ivandivito/gepetto/circuitos/circuito control/circuito_control_esquematico.jpg

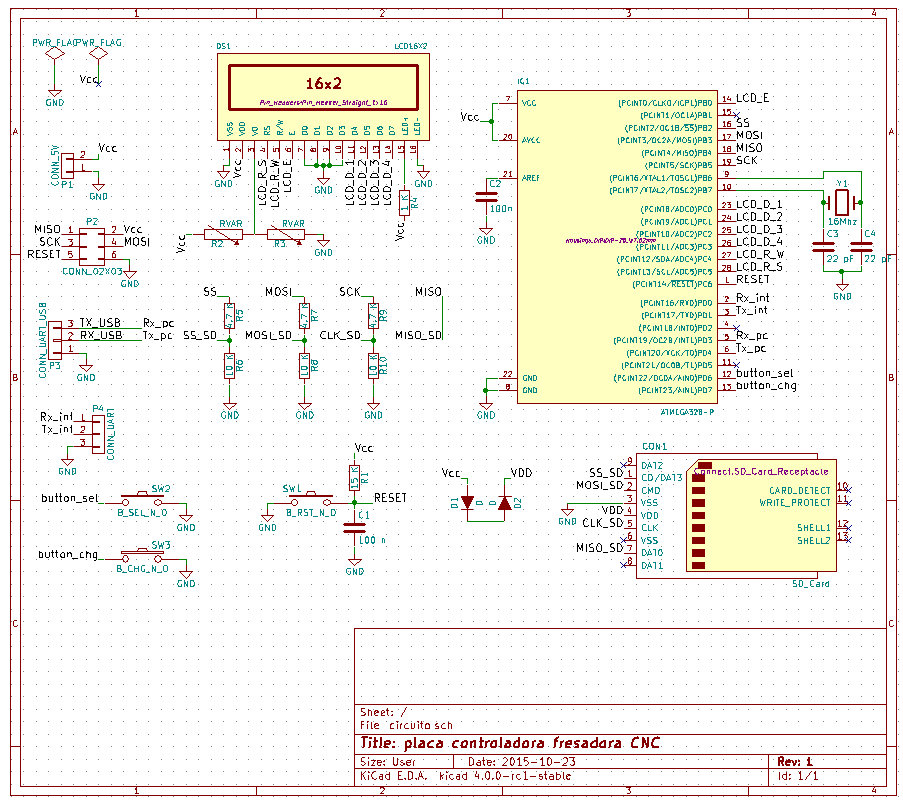
circuitos/circuito control/circuito_control_esquematico.jpg
