ivandivito/gepetto/circuitos/circuito control/circuito_control_pcv.jpg

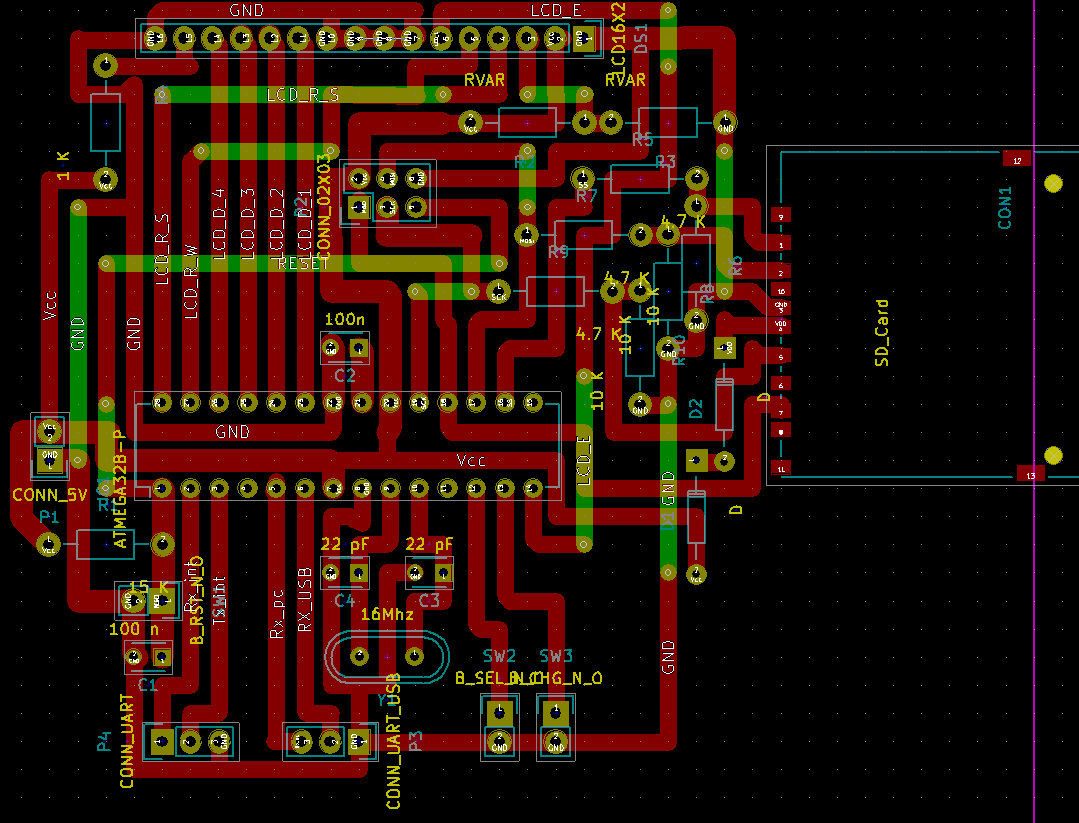
circuitos/circuito control/circuito_control_pcv.jpg
