ivandivito/gepetto/circuitos/circuito interprete/esquematico interprete.jpg

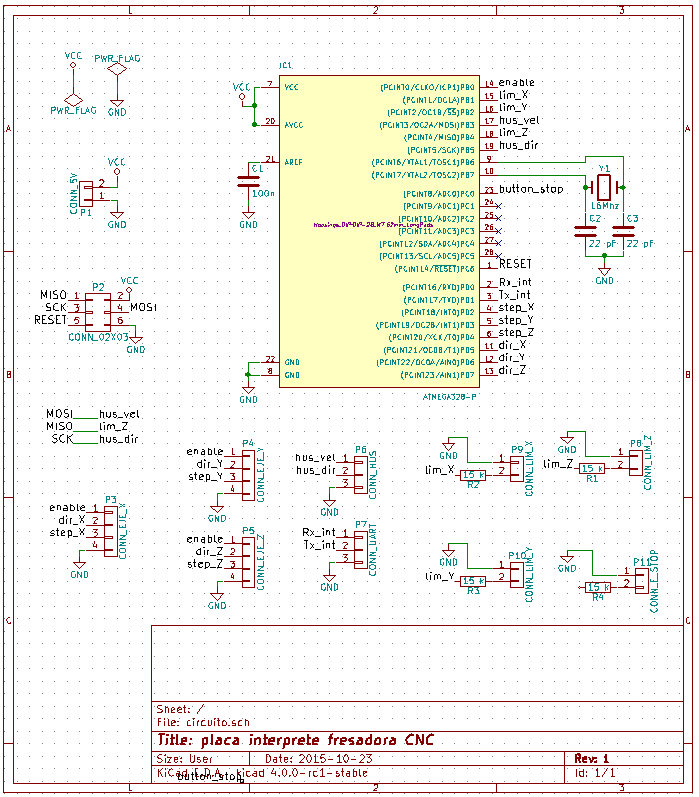
circuitos/circuito interprete/esquematico interprete.jpg
