ivandivito/gepetto/circuitos/circuito interprete/pcv interprete.jpg

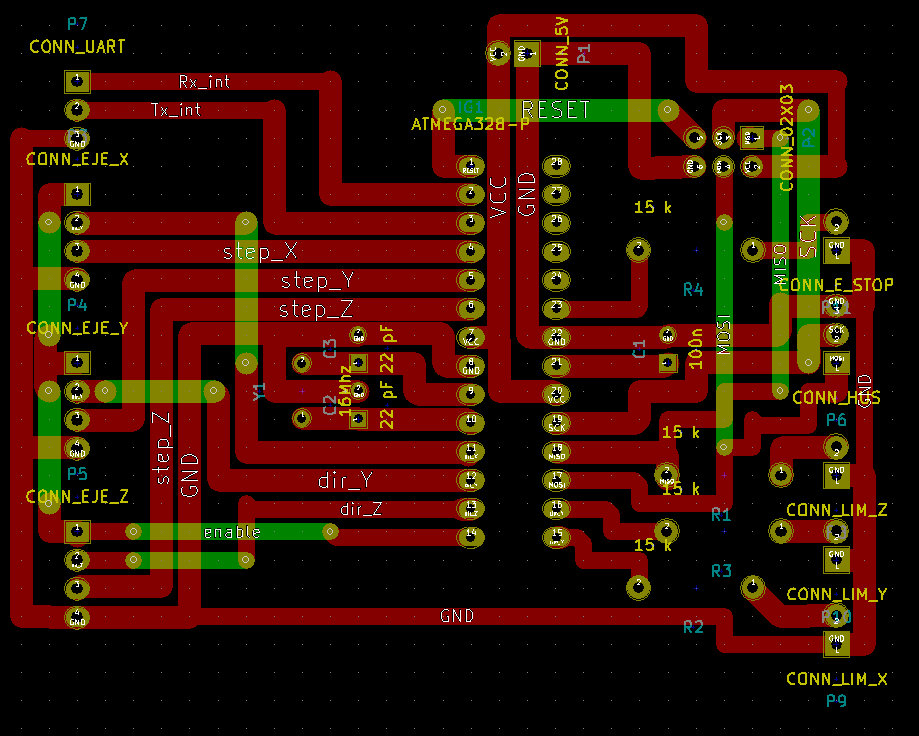
circuitos/circuito interprete/pcv interprete.jpg
