ivandivito/gepetto/circuitos/circuito control/control.pdf

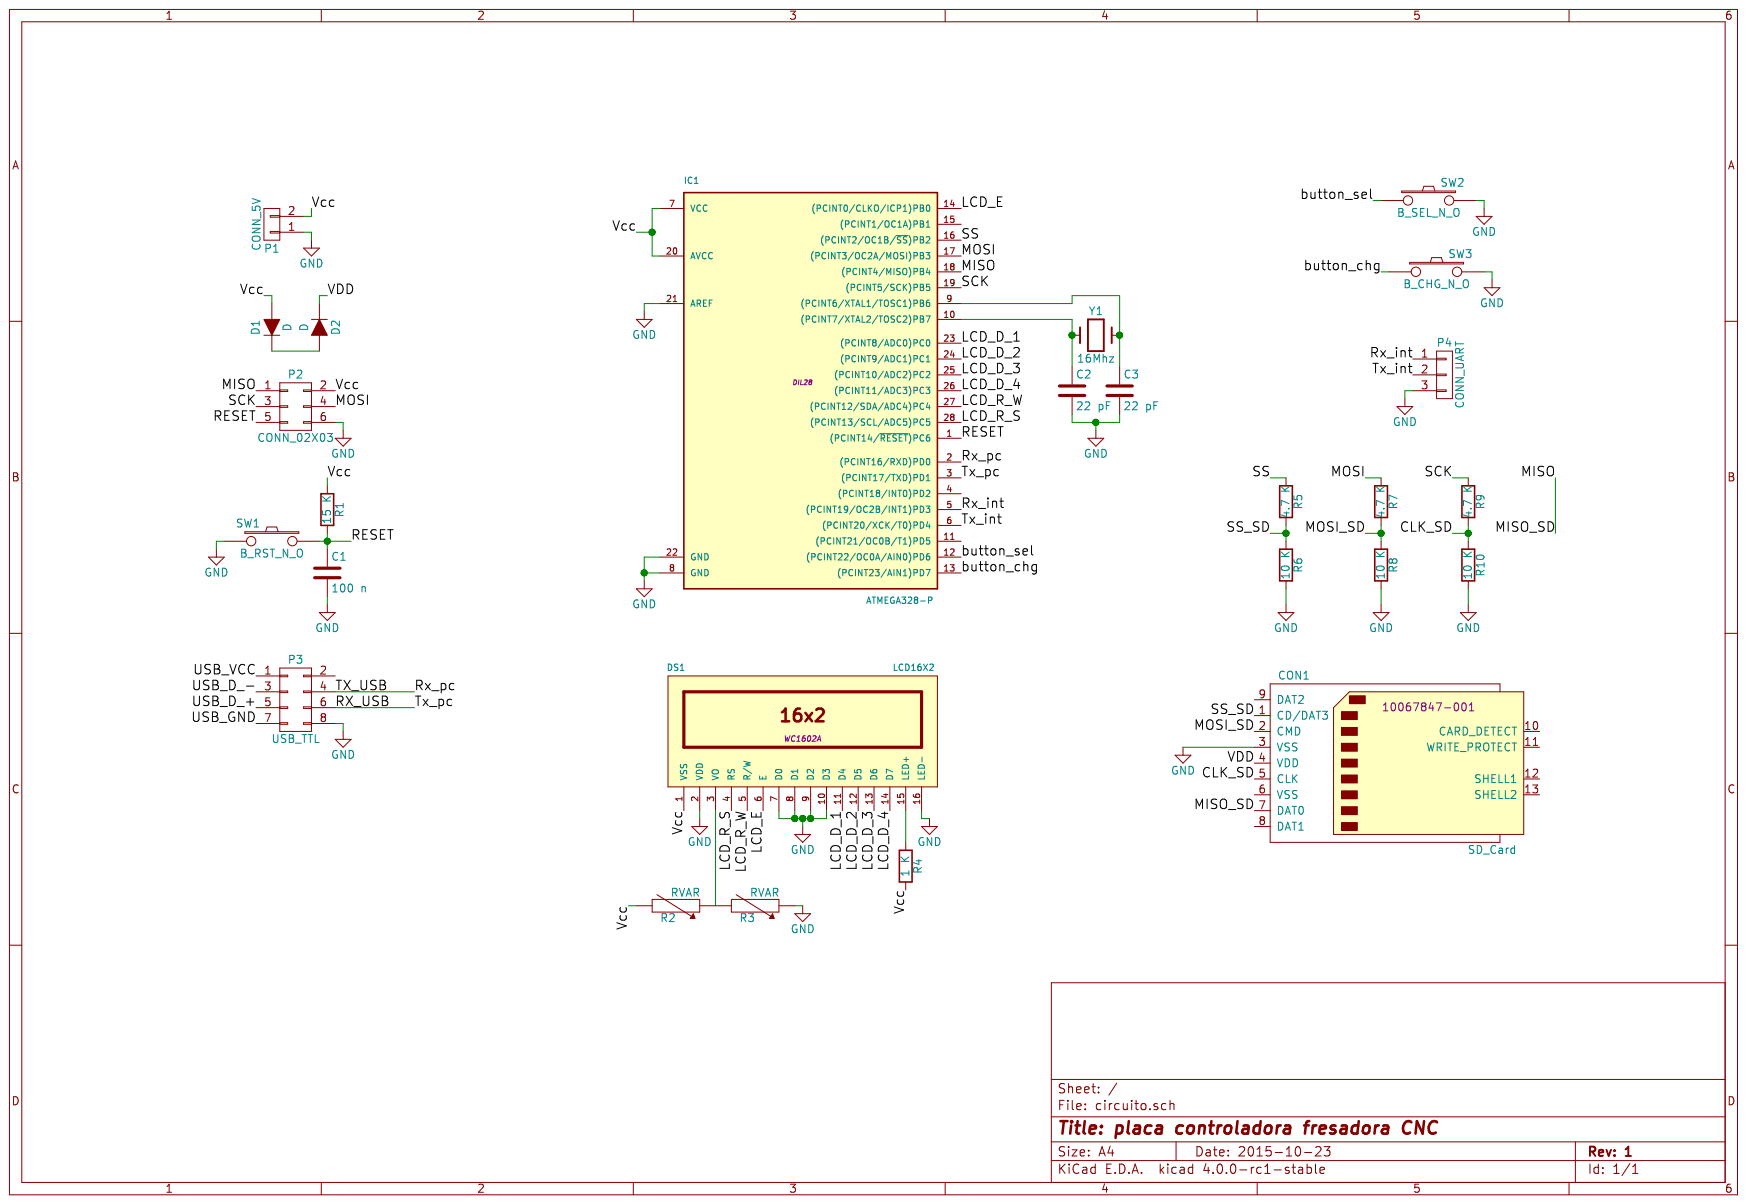
[picture p9: page 1]
