ivandivito/gepetto/circuitos/circuito interprete/interprete.pdf

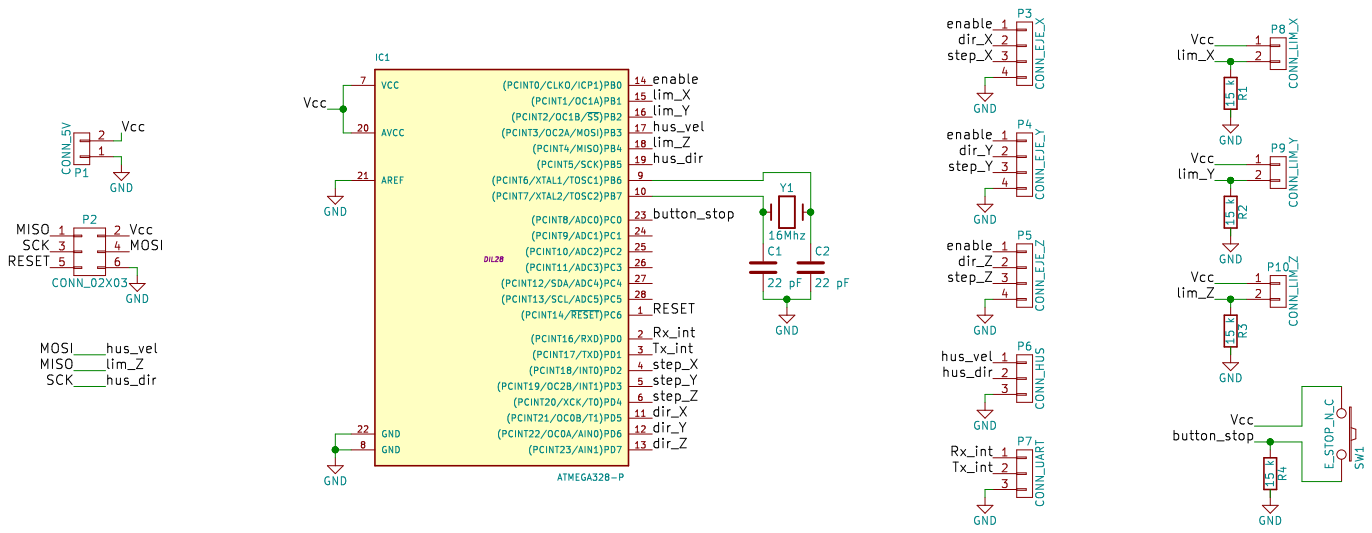
[picture p10: page 1]
