ivandivito/gepetto/circuitos/circuito interprete/circuito.kicad_pcb

## KiCad design circuitos/circuito interprete/circuito.kicad_pcb (2015-11-24)

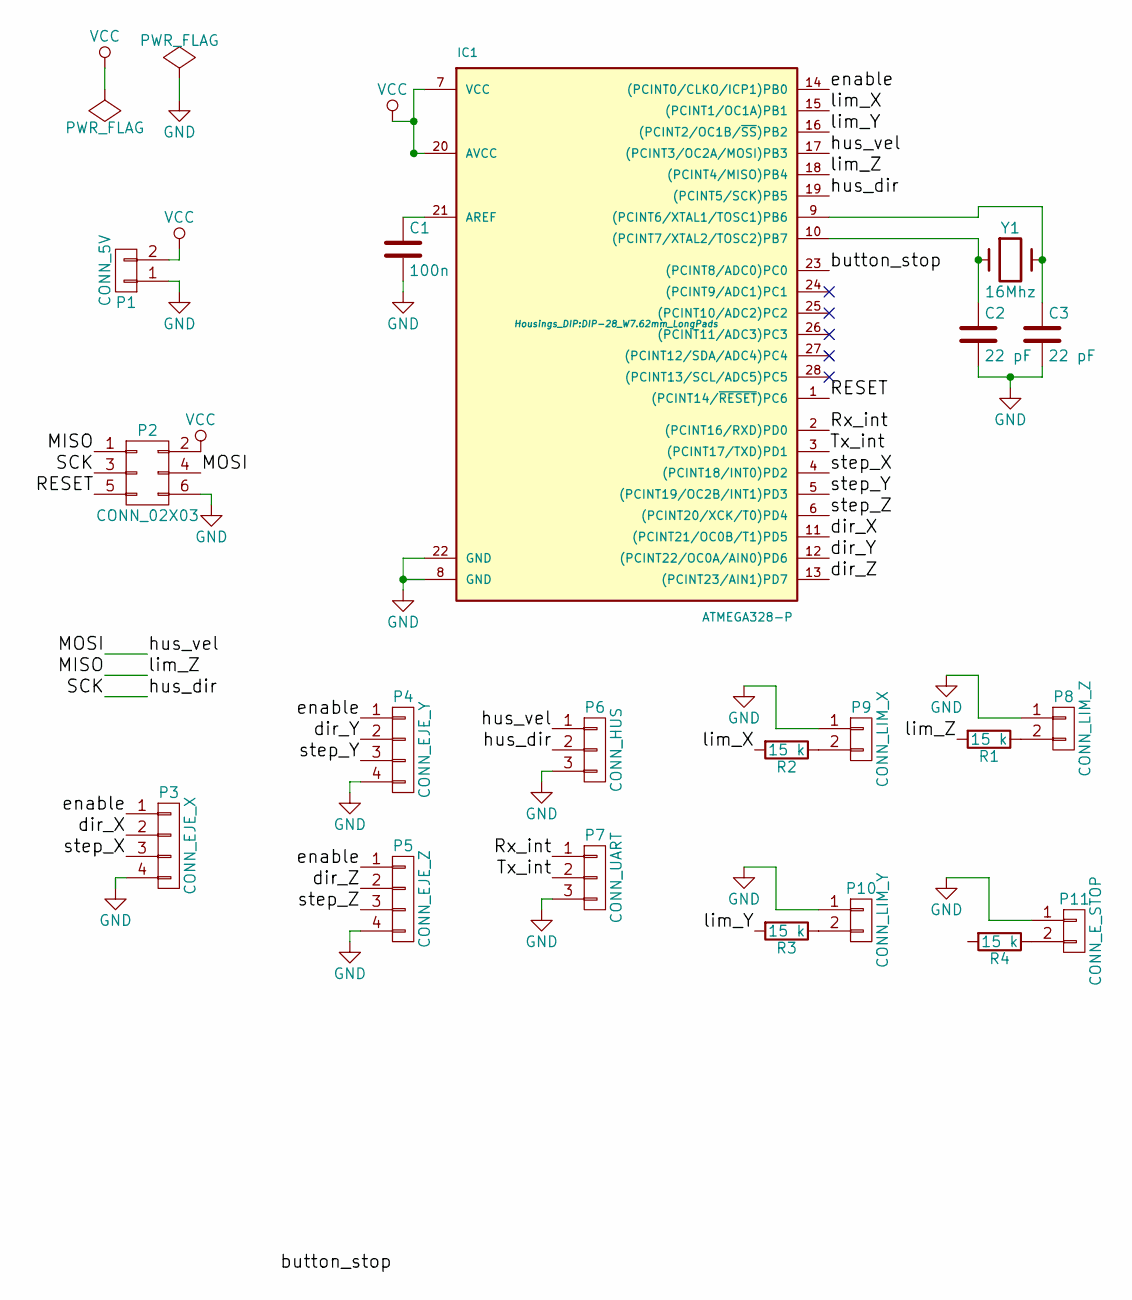
[picture p11: schematic circuito.sch, placa interprete fresadora CNC]

Parts:
C1: 100n; C_Disc_D3_P2.5
C2, C3: 22 pF; C_Disc_D3_P2.5
IC1: ATMEGA328-P; DIP-28_W7.62mm_LongPads
P1: CONN_5V; Pin_Header_Straight_1x02
P2: CONN_02X03; Pin_Header_Straight_2x03
P3: CONN_EJE_X; Pin_Header_Straight_1x04
P4: CONN_EJE_Y; Pin_Header_Straight_1x04
P5: CONN_EJE_Z; Pin_Header_Straight_1x04
P6: CONN_HUS; Pin_Header_Straight_1x03
P7: CONN_UART; Pin_Header_Straight_1x03
P8: CONN_LIM_Z; Pin_Header_Straight_1x02
P9: CONN_LIM_X; Pin_Header_Straight_1x02
P10: CONN_LIM_Y; Pin_Header_Straight_1x02
P11: CONN_E_STOP; Pin_Header_Straight_1x02
R1, R2, R3, R4: 15 k; Resistor_Horizontal_RM10mm
Y1: 16Mhz; Crystal_HC48-U_Vertical

Connections:
/MISO: IC1.18 ((PCINT4/MISO)PB4), P2.1, R1.2
/MOSI: IC1.17 ((PCINT3/OC2A/MOSI)PB3), P2.4, P6.1
/RESET: IC1.1 ((PCINT14/~RESET~)PC6), P2.5
/Rx_int: IC1.2 ((PCINT16/RXD)PD0), P7.1
/SCK: IC1.19 ((PCINT5/SCK)PB5), P2.3, P6.2
/Tx_int: IC1.3 ((PCINT17/TXD)PD1), P7.2
/button_stop: IC1.23 ((PCINT8/ADC0)PC0), R4.2
/dir_X: IC1.11 ((PCINT21/OC0B/T1)PD5), P3.2
/dir_Y: IC1.12 ((PCINT22/OC0A/AIN0)PD6), P4.2
/dir_Z: IC1.13 ((PCINT23/AIN1)PD7), P5.2
/enable: IC1.14 ((PCINT0/CLKO/ICP1)PB0), P3.1, P4.1, P5.1
/lim_X: IC1.15 ((PCINT1/OC1A)PB1), R2.2
/lim_Y: IC1.16 ((PCINT2/OC1B/~SS~)PB2), R3.2
/step_X: IC1.4 ((PCINT18/INT0)PD2), P3.3
/step_Y: IC1.5 ((PCINT19/OC2B/INT1)PD3), P4.3
/step_Z: IC1.6 ((PCINT20/XCK/T0)PD4), P5.3
GND: C1.2, C2.2, C3.2, IC1.8 (GND), IC1.22 (GND), P1.1, P2.6, P3.4, P4.4, P5.4, P6.3, P7.3, P8.1, P9.1, P10.1, P11.1
unnamed: C1.1, IC1.21 (AREF)
unnamed: C2.1, IC1.10 ((PCINT7/XTAL2/TOSC2)PB7), Y1.1
unnamed: C3.1, IC1.9 ((PCINT6/XTAL1/TOSC1)PB6), Y1.2
unnamed: P8.2, R1.1
unnamed: P9.2, R2.1
unnamed: P10.2, R3.1
unnamed: P11.2, R4.1
VCC: IC1.7 (VCC), IC1.20 (AVCC), P1.2, P2.2

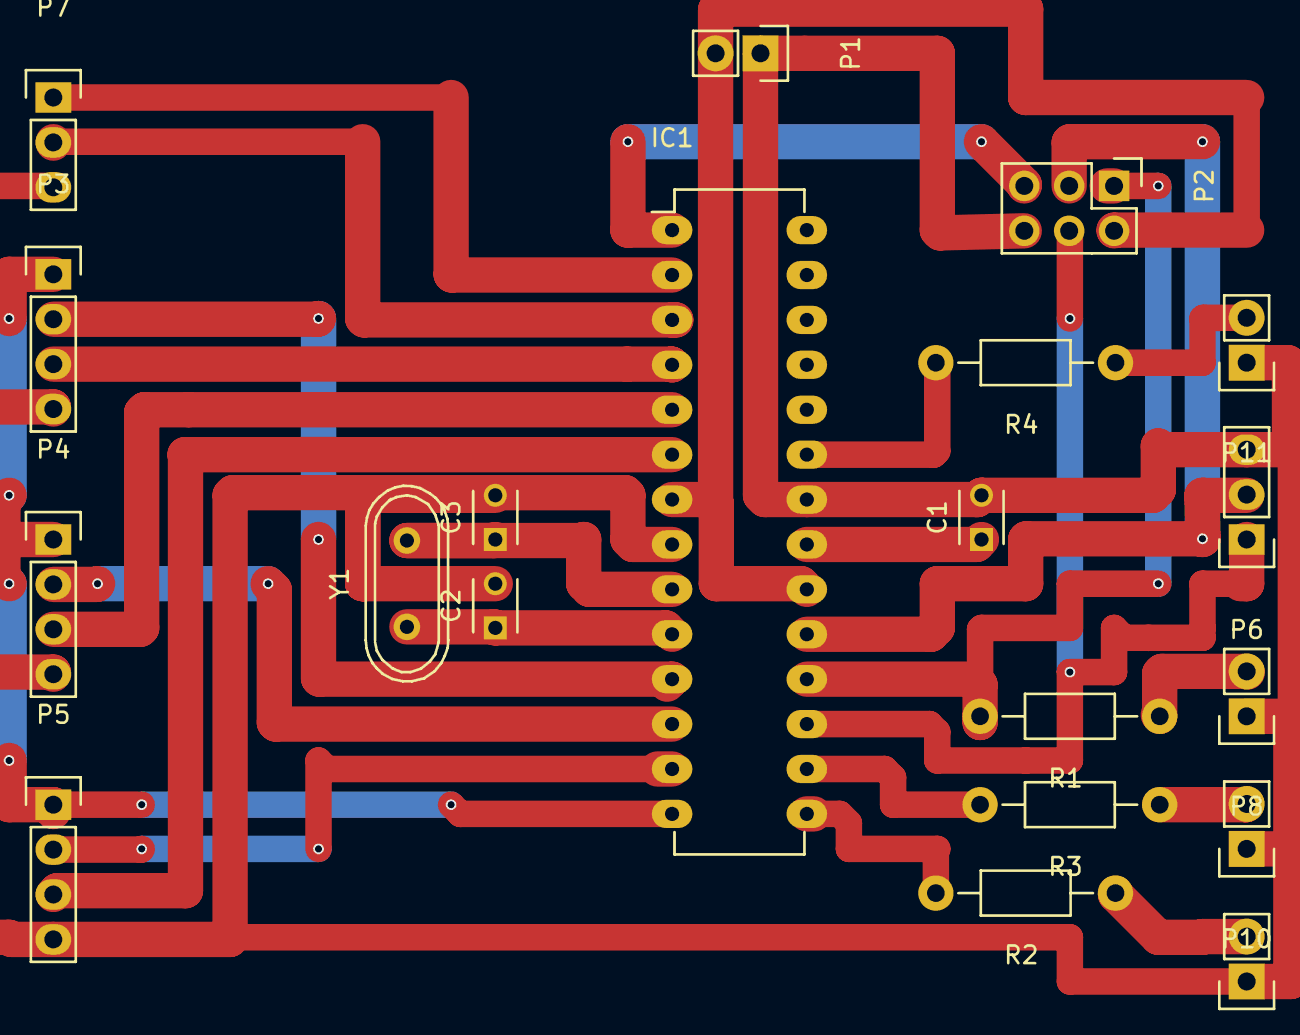
[picture p12: board circuitos/circuito interprete/circuito.kicad_pcb from above]

Board: 2 copper layers, 20 parts (0 on the bottom side), 25 nets.
