ivandivito/gepetto/circuitos/circuito control/circuito.kicad_pcb

## KiCad design circuitos/circuito control/circuito.kicad_pcb (2015-11-24)

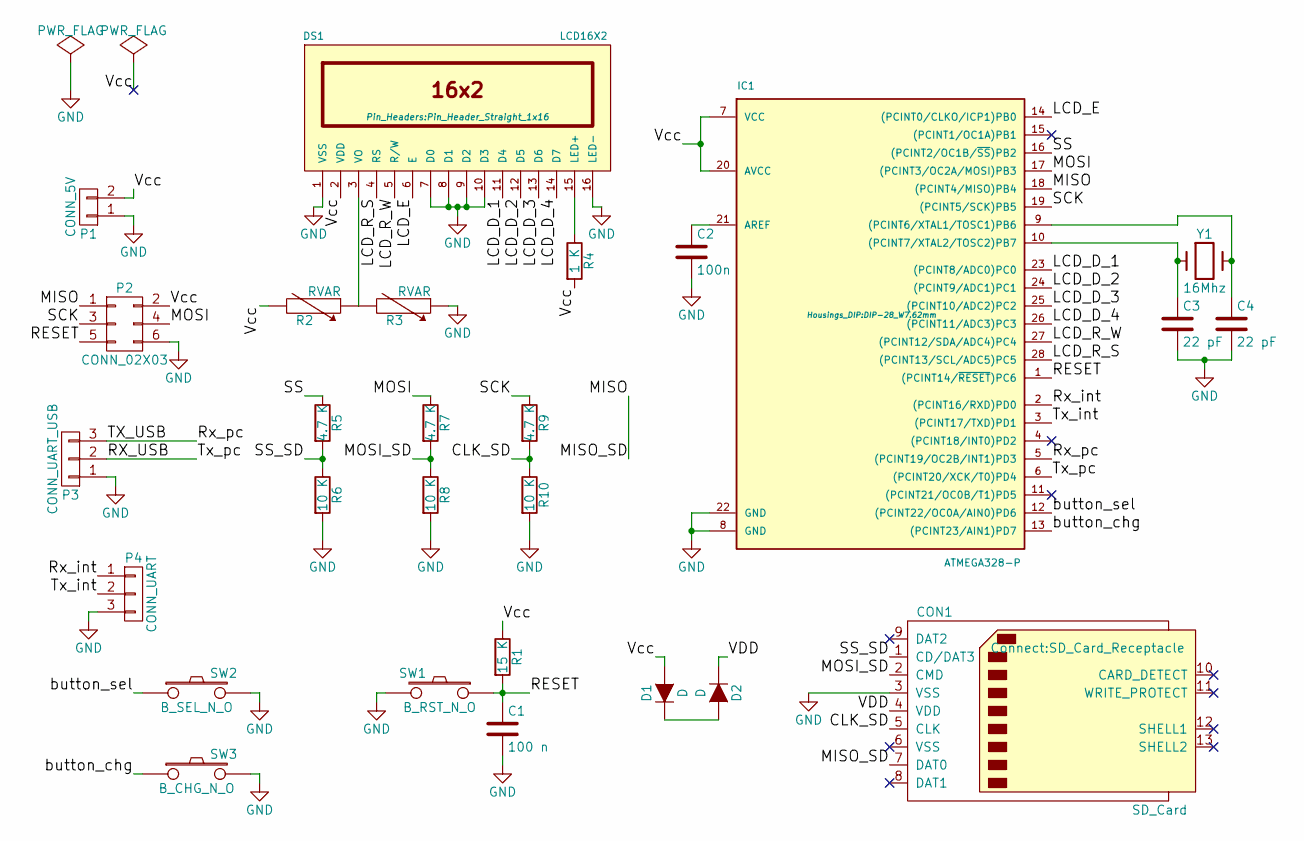
[picture p13: schematic circuito.sch, placa controladora fresadora CNC]

Parts:
C1: 100 n; C_Disc_D3_P2.5
C2: 100n; C_Disc_D3_P2.5
C3, C4: 22 pF; C_Disc_D3_P2.5
CON1: SD_Card; SD_Card_Receptacle
D1, D2: D; Diode_DO-35_SOD27_Horizontal_RM10
DS1: LCD16X2; Pin_Header_Straight_1x16
IC1: ATMEGA328-P; DIP-28_W7.62mm
P1: CONN_5V; Pin_Header_Straight_1x02
P2: CONN_02X03; Pin_Header_Straight_2x03
P3: CONN_UART_USB; Pin_Header_Straight_1x03
P4: CONN_UART; Pin_Header_Straight_1x03
R1: 15 K; Resistor_Horizontal_RM10mm
R2, R3: RVAR; Resistor_Horizontal_RM10mm
R4: 1 K; Resistor_Horizontal_RM10mm
R5, R7, R9: 4.7 K; Resistor_Horizontal_RM10mm
R6, R8, R10: 10 K; Resistor_Horizontal_RM10mm
SW1: B_RST_N_O; Pin_Header_Straight_1x02
SW2: B_SEL_N_O; Pin_Header_Straight_1x02
SW3: B_CHG_N_O; Pin_Header_Straight_1x02
Y1: 16Mhz; Crystal_HC49-U_Vertical

Connections:
/CLK_SD: CON1.5 (CLK), R9.2, R10.1
/LCD_D_1: DS1.11 (D4), IC1.23 ((PCINT8/ADC0)PC0)
/LCD_D_2: DS1.12 (D5), IC1.24 ((PCINT9/ADC1)PC1)
/LCD_D_3: DS1.13 (D6), IC1.25 ((PCINT10/ADC2)PC2)
/LCD_D_4: DS1.14 (D7), IC1.26 ((PCINT11/ADC3)PC3)
/LCD_E: DS1.6 (E), IC1.14 ((PCINT0/CLKO/ICP1)PB0)
/LCD_R_S: DS1.4 (RS), IC1.28 ((PCINT13/SCL/ADC5)PC5)
/LCD_R_W: DS1.5 (R/W), IC1.27 ((PCINT12/SDA/ADC4)PC4)
/MISO: CON1.7 (DAT0), IC1.18 ((PCINT4/MISO)PB4), P2.1
/MOSI: IC1.17 ((PCINT3/OC2A/MOSI)PB3), P2.4, R7.1
/MOSI_SD: CON1.2 (CMD), R7.2, R8.1
/RESET: C1.1, IC1.1 ((PCINT14/~RESET~)PC6), P2.5, R1.2, SW1.1
/RX_USB: IC1.6 ((PCINT20/XCK/T0)PD4), P3.2
/Rx_int: IC1.2 ((PCINT16/RXD)PD0), P4.1
/Rx_pc: IC1.5 ((PCINT19/OC2B/INT1)PD3), P3.3
/SCK: IC1.19 ((PCINT5/SCK)PB5), P2.3, R9.1
/SS: IC1.16 ((PCINT2/OC1B/~SS~)PB2), R5.1
/SS_SD: CON1.1 (CD/DAT3), R5.2, R6.1
/Tx_int: IC1.3 ((PCINT17/TXD)PD1), P4.2
/VDD: CON1.4 (VDD), D2.1 (K)
/Vcc: D1.2 (A), DS1.2 (VDD), IC1.7 (VCC), IC1.20 (AVCC), P1.2, P2.2, R1.1, R2.2, R4.2
/button_chg: IC1.13 ((PCINT23/AIN1)PD7), SW3.1
/button_sel: IC1.12 ((PCINT22/OC0A/AIN0)PD6), SW2.1
GND: C1.2, C2.2, C3.2, C4.2, CON1.3 (VSS), DS1.1 (VSS), DS1.7 (D0), DS1.8 (D1), DS1.9 (D2), DS1.10 (D3), DS1.16 (LED-), IC1.8 (GND), IC1.22 (GND), P1.1, P2.6, P3.1, P4.3, R3.1, R6.2, R8.2, R10.2, SW1.2, SW2.2, SW3.2
unnamed: C2.1, IC1.21 (AREF)
unnamed: C3.1, IC1.10 ((PCINT7/XTAL2/TOSC2)PB7), Y1.1
unnamed: C4.1, IC1.9 ((PCINT6/XTAL1/TOSC1)PB6), Y1.2
unnamed: D1.1 (K), D2.2 (A)
unnamed: DS1.3 (VO), R2.1, R3.2
unnamed: DS1.15 (LED+), R4.1

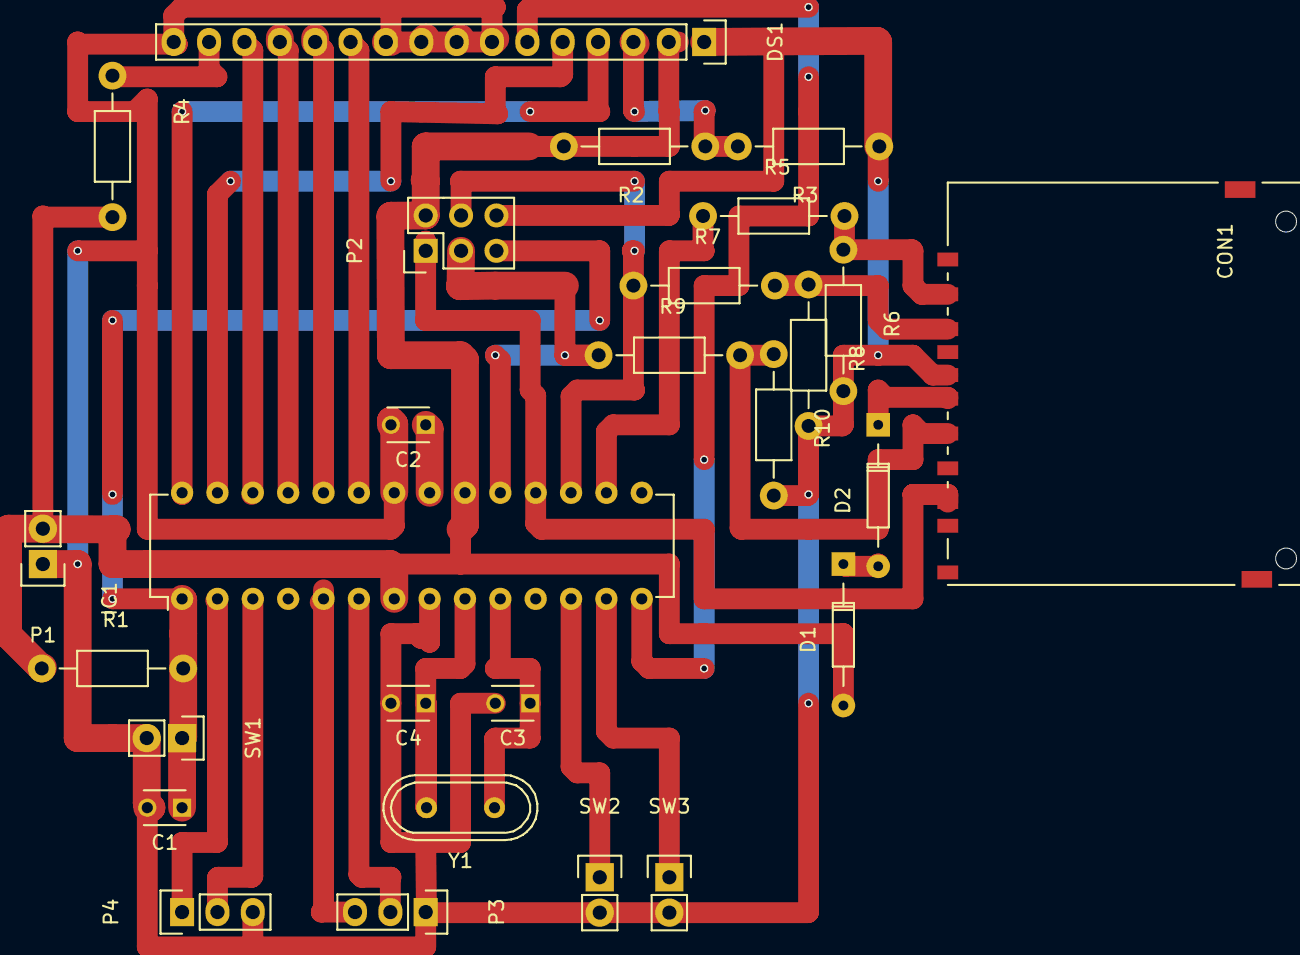
[picture p14: board circuitos/circuito control/circuito.kicad_pcb from above]

Board: 2 copper layers, 27 parts (0 on the bottom side), 30 nets.
