ivandivito/gepetto/src/ui.asm

.CSEG

UI_TEXT_GEPETTO:	.DB "Gepetto         ", 0
UI_TEXT_1:			.DB "Primera linea   ", 0
UI_TEXT_2:			.DB "Segunda linea   ", 0

.DEF TEMP = R16

UI_INIT:
	
	CALL LCD_INIT
	
	;Delay 15ms
	LDI R16, 177
	LDI R17, 56
	LDI R18, 2
	CALL DELAY_3_REG
	
	CBI LCD_PORT, LCD_RS		;Enviar a registro de intrucciones

	LDI TEMP, 0x30
	CALL LCD_SEND_NIBBLE		;Interfaz 8bit
	
	;Delay 4.1ms
	LDI R16, 51
	LDI R17, 86
	CALL DELAY_2_REG
	
	LDI TEMP, 0x30
	CALL LCD_SEND_NIBBLE		;Interfaz 8bit
	
	;Delay 100us
	LDI R16, 21
	LDI R17, 3
	CALL DELAY_2_REG
	
	LDI TEMP, 0x30
	CALL LCD_SEND_NIBBLE		;Interfaz 8bit
	
	RCALL UI_WAIT_LCD_READY
	
	LDI TEMP, 0x20
	CALL LCD_SEND_NIBBLE		;Interfaz 4bit
	

	LDI TEMP, 0x28				;Interfaz 4bit, 2 lineas, font 5x8
	CALL UI_SEND_INSTRUCTION
	
	LDI TEMP, 0x0C				;Display on, cursor off, blink off
	CALL UI_SEND_INSTRUCTION
	
	LDI TEMP, 0x01				;Display clear
	CALL UI_SEND_INSTRUCTION
	
	LDI TEMP, 0x06				;Increment, No display shift
	CALL UI_SEND_INSTRUCTION
	
	RET


;Subrutina que espera a que el LCD este listo

.DEF READ_REG = R16
	
UI_WAIT_LCD_READY:
	
	CBI LCD_PORT, LCD_RS		;Leer de registro de intrucciones
	
	CALL LCD_READ_BYTE
	ANDI READ_REG, (1<<LCD_BF)	;Verificar el Busy Flag
	BRNE UI_WAIT_LCD_READY

	RET


;Subrutina para enviar un caracter al LCD	

.DEF CHAR_REG = R16
	
UI_SEND_INSTRUCTION:
	
	PUSH CHAR_REG
	RCALL UI_WAIT_LCD_READY		;Esperar a que este listo
	POP CHAR_REG
	
	CBI LCD_PORT, LCD_RS		;Escribir en registro de instrucciones
	
	CALL LCD_SEND_BYTE
	
	RET

;Subrutina para enviar un caracter al LCD	

.DEF CHAR_REG = R16
	
UI_WRITE_CHAR:
	
	PUSH CHAR_REG
	RCALL UI_WAIT_LCD_READY		;Esperar a que este listo
	POP CHAR_REG
	
	SBI LCD_PORT, LCD_RS		;Escribir en registro de datos
	
	CALL LCD_SEND_BYTE
	
	RET

;Subrutina para enviar un String al LCD. El string es apuntado por Z y termina en 0

.DEF CHAR_REG = R16

UI_WRITE_P_STRING:
	PUSH ZL
	PUSH ZH

	UI_WRITE_P_STRING_LOOP:
		LPM CHAR_REG, Z+
		TST CHAR_REG
		BREQ UI_WRITE_P_STRING_LOOP_BREAK

		RCALL UI_WRITE_CHAR
		
		RJMP UI_WRITE_P_STRING_LOOP

	UI_WRITE_P_STRING_LOOP_BREAK:

	POP ZH
	POP ZL
	RET


;Subrutina para escribir un String a la primera linea LCD. El string es apuntado por Z y termina en 0

.DEF TEMP = R16

UI_WRITE_FIRST_LINE_P_STRING:
	
	LDI TEMP, (1<<7) | 0x00			;Cursor en cero
	CALL UI_SEND_INSTRUCTION

	CALL UI_WRITE_P_STRING

	RET

;Subrutina para escribir un String a la primera linea LCD. El string es apuntado por Z y termina en 0

.DEF TEMP = R16

UI_WRITE_SECOND_LINE_P_STRING:
	
	LDI TEMP, (1<<7) | 0x40			;Cursor en 0x40
	CALL UI_SEND_INSTRUCTION

	CALL UI_WRITE_P_STRING

	RET

;Subrutina para enviar un String al LCD. El string es apuntado por X y termina en \n

.DEF CHAR_REG = R16

UI_WRITE_D_STRING:
	PUSH XL
	PUSH XH

	UI_WRITE_D_STRING_LOOP:
		LD CHAR_REG, X+
		CPI CHAR_REG, '\n'
		BREQ UI_WRITE_D_STRING_LOOP_BREAK

		RCALL UI_WRITE_CHAR
		
		RJMP UI_WRITE_D_STRING_LOOP

	UI_WRITE_D_STRING_LOOP_BREAK:

	POP XH
	POP XL
	RET


;Subrutina para escribir un String a la primera linea LCD. El string es apuntado por X y termina en \n

.DEF TEMP = R16

UI_WRITE_FIRST_LINE_D_STRING:
	
	LDI TEMP, (1<<7) | 0x00			;Cursor en cero
	CALL UI_SEND_INSTRUCTION

	CALL UI_WRITE_D_STRING

	RET
