ivandivito/gepetto/(commit log)

2015-10-23 agrego esquematicos circuitos
    agrego esquematicos de los circuitos interprete y controlador echos en
    kicad y exportados en PDF
    [circuito.kicad_pcb, circuito.sch]
2015-10-29 agrego ruteo de placas
    [circuito.kicad_pcb]
2015-10-30 Soft Uart
2015-10-31 cambios esquematicos varios
    [circuito.kicad_pcb, circuito.sch]
2015-10-31 Macros para buffers
2015-10-31 Adaptar Soft UART a atmega328p
2015-11-02 Subrutinas para botones
2015-11-04 cambios en el circuito de pull down.
    [circuito.kicad_pcb, circuito.sch]
2015-11-08 Separar subrutinas de estado
2015-11-08 Subrutinas de comunicacion USB y GRBL
2015-11-08 Bug fix, los botones ahora detectan flancos y no estado
    [buttons.asm, idle.asm, main.asm]
2015-11-09 conexion spi y targeta SD
2015-11-10 Organizacion de archivos en includes
2015-11-13 Soft UART bug fixes
    [connected.asm, grbl_comunication.asm, idle.asm, main.asm, soft_uart.asm]
2015-11-14 Subi el datasheet del LCD
2015-11-14 ahi va el otro datasheet del LCD
2015-11-15 Tiempos de LCD optimizados
2015-11-15 Subrutinas para escribir en pantalla
2015-11-15 Saltos de estado por interfaz y bug fixing
    [connected.asm, constants.asm, idle.asm]
2015-11-15 Timer de tiempo del sistema extendido
2015-11-18 prueba UART
2015-11-18 documentacion de SD
2015-11-20 Protocolo de transferencia de archivo implementado
2015-11-20 agrego implementaciones de running
2015-11-20 Archivo transferido a la SD
2015-11-20 la inicializacion de la SD ahora revisa si hay un programa en memoria
2015-11-24 adapto graficos para el informe
    [circuito.kicad_pcb, circuito.sch]
